rayolsen/Teensy_3_5_VGM_Player_YM2612_SN76489/Docs/Baordv1.2_render_screenshot.png

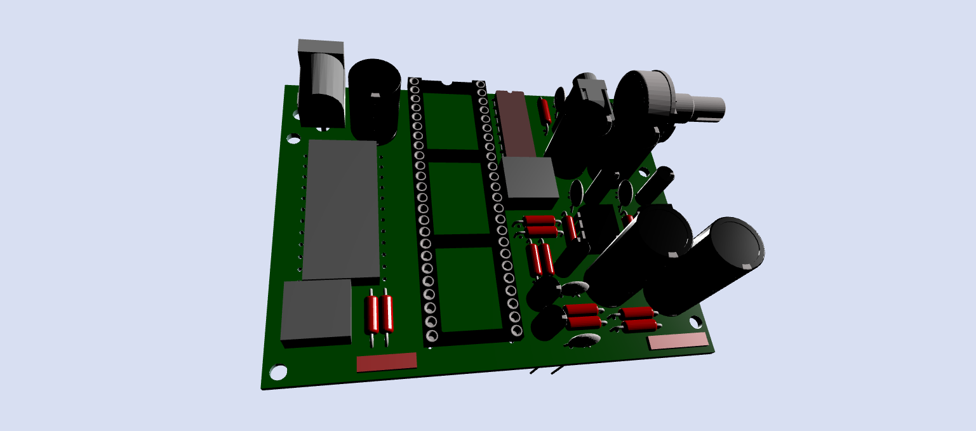
Docs/Baordv1.2_render_screenshot.png
