rayolsen/Teensy_3_5_VGM_Player_YM2612_SN76489/Docs/Case/Case_render_v12.png

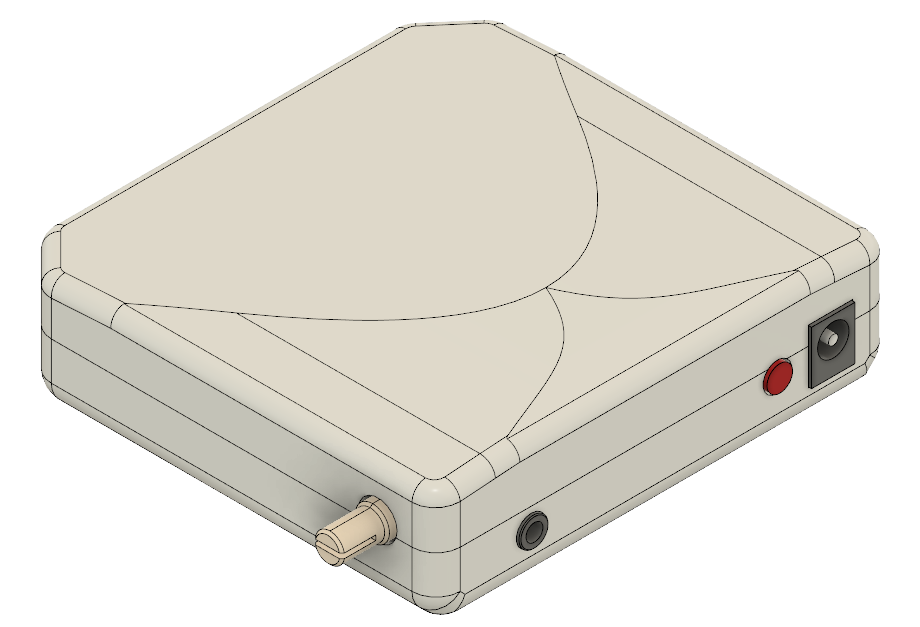
Docs/Case/Case_render_v12.png
