rayolsen/Teensy_3_5_VGM_Player_YM2612_SN76489/Schematics/board_top_gnd_plane.png

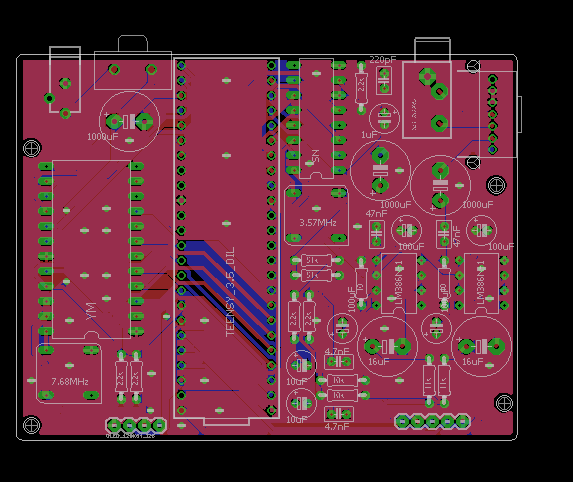
Schematics/board_top_gnd_plane.png
