rayolsen/Teensy_3_5_VGM_Player_YM2612_SN76489/Schematics/Schematic.png

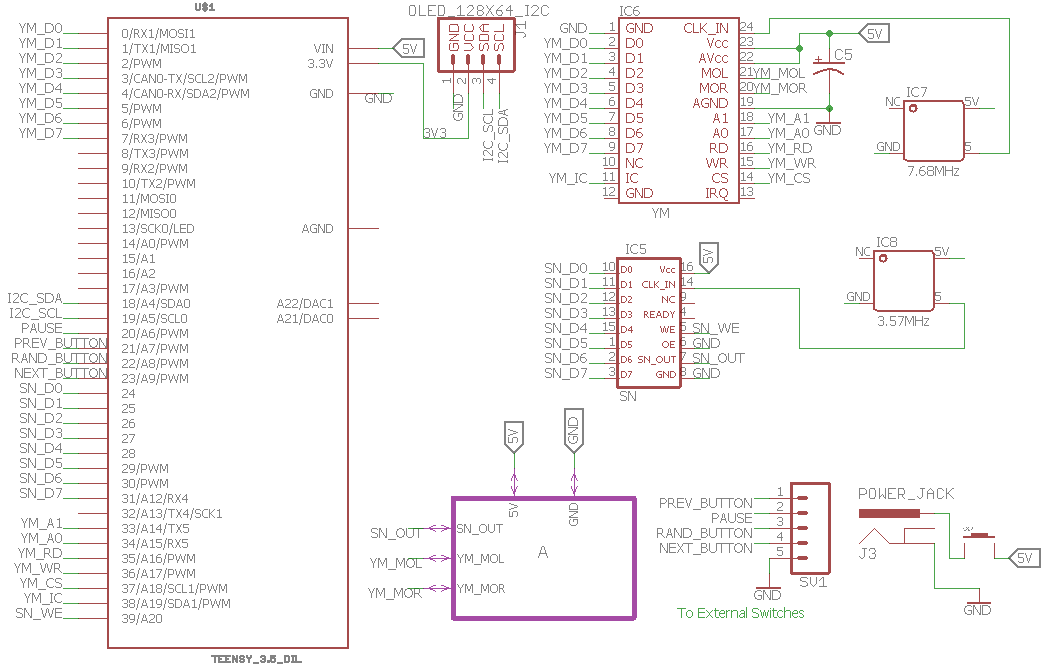
Schematics/Schematic.png
