rayolsen/Teensy_3_5_VGM_Player_YM2612_SN76489/Docs/Case/Bottom_Case.stl

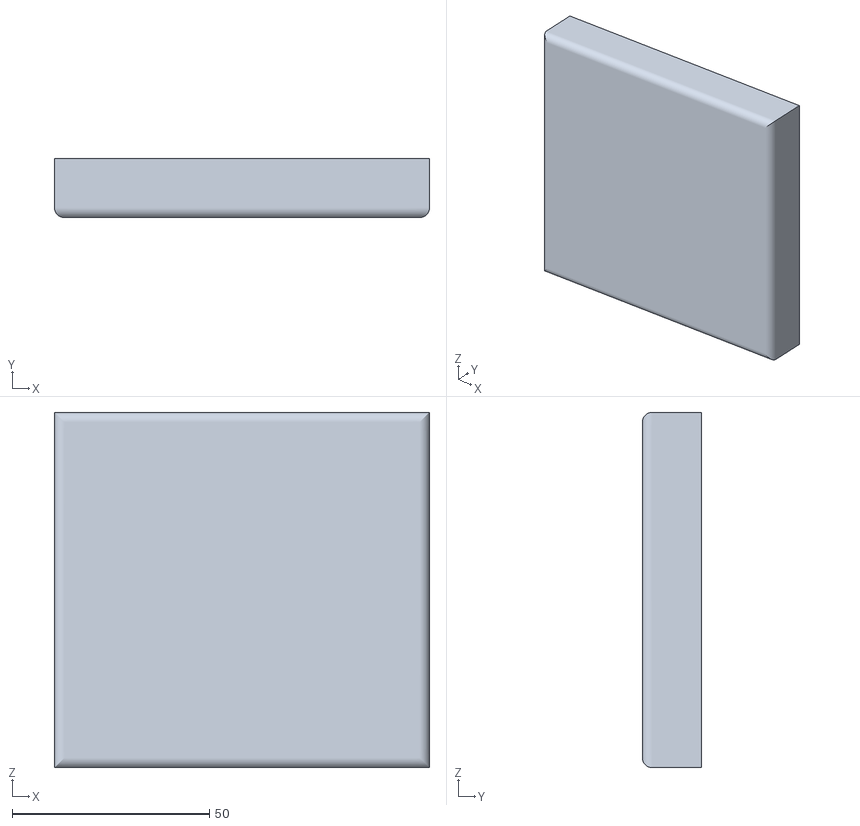
[picture p5: CAD file, 2018-01-02]
Docs/Case/Bottom_Case.stl
95.0 x 15.0 x 90.0
