rayolsen/Teensy_3_5_VGM_Player_YM2612_SN76489/Docs/Case/Boardv1.2_render_low-poly.STL

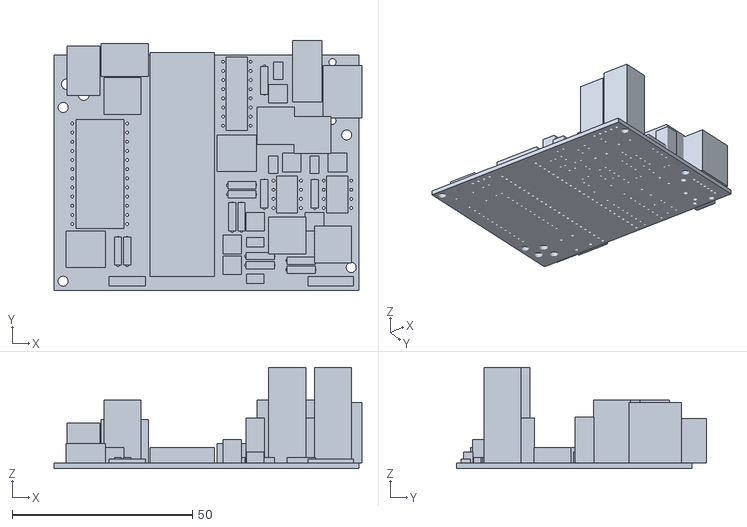
[picture p6: CAD file, 2018-01-02]
Docs/Case/Boardv1.2_render_low-poly.STL
85.5 x 69.4 x 28.1
