rayolsen/Teensy_3_5_VGM_Player_YM2612_SN76489/Schematics/Teensy_3_5_VGM_Player.pdf

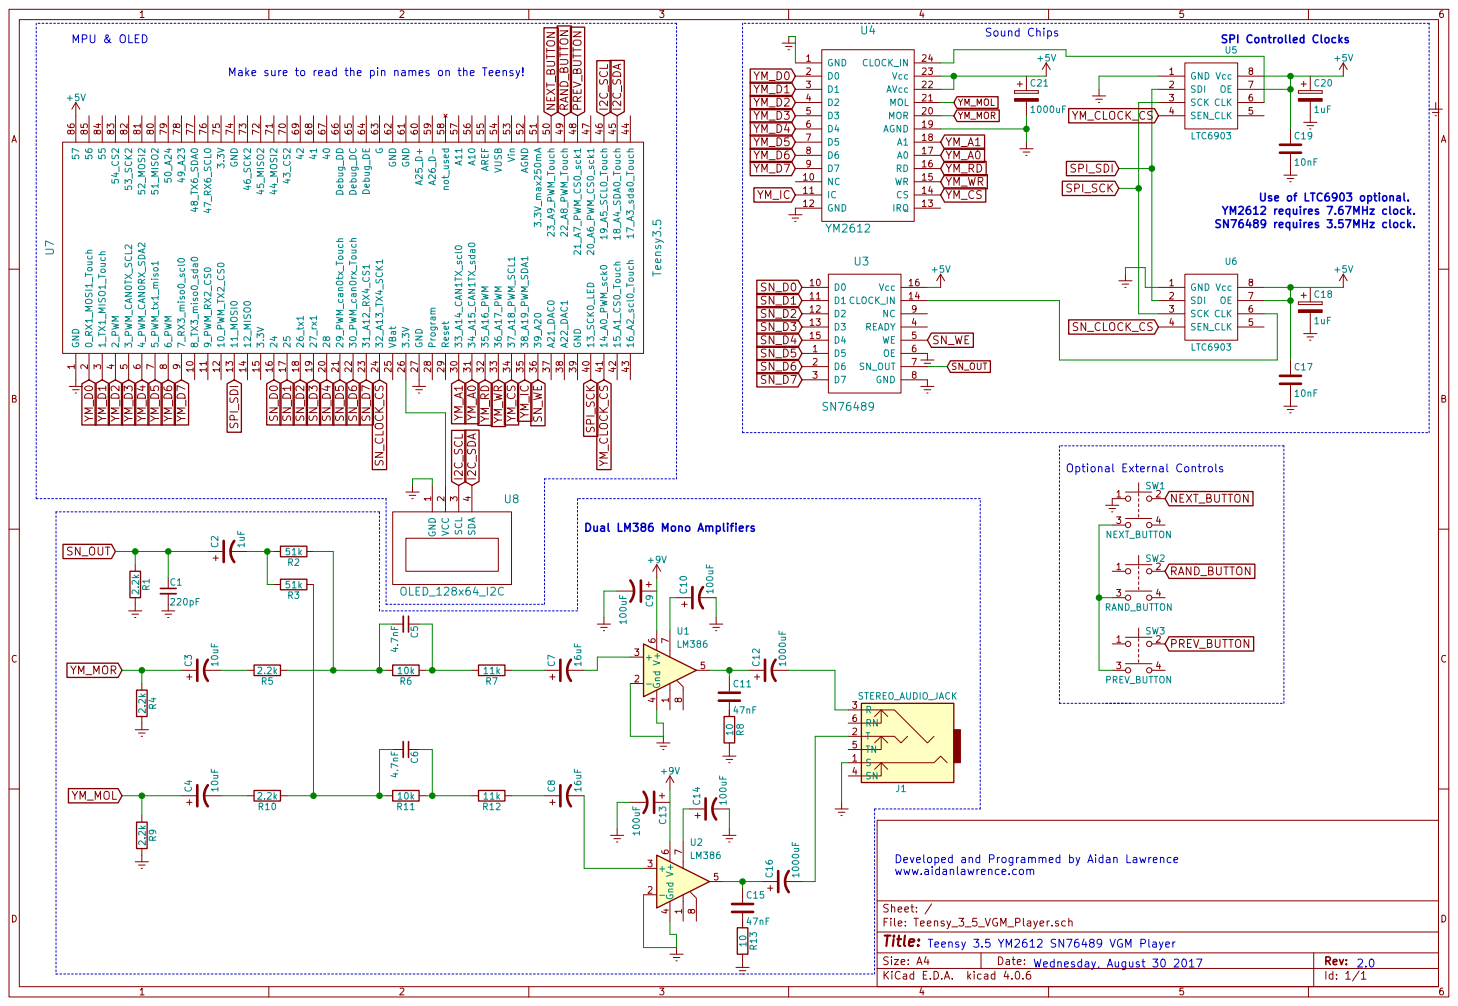
[picture p7: page 1]

Make sure to read the pin names on the Teensy! GND

9 8_TX3_miso0_sda0 10 28 20 33_A14_CAN1TX_scl0 30 13_SCK0_LED 40 23_A9_PWM_Touch 50 A25_D+ 60 43_CS2 70 51_MISO2 80 9_PWM_RX2_CS0 11 29_PWM_can0tx_Touch 21 34_A15_CAN1TX_sda0 31 14_A0_PWM_sck0 41 3.3V_max250mA 51 GND 61 44_MOSI2 71 52_MOSI2 81 10_PWM_TX2_CS0 12 30_PWM_can0rx_Touch 22 35_A16_PWM 32 15_A1_CS0_Touch 42 AGND 52 GND 62 45_MISO2 72 53_SCK2 82 11_MOSI0 13 31_A12_RX4_CS1 23 36_A17_PWM 33 16_A2_scl0_Touch 43 Vin 53 G 63 46_SCK2 73 54_CS2 83 12_MISO0 14 32_A13_TX4_SCK1 24 37_A18_PWM_SCL1 34 17_A3_sda0_Touch 44 VUSB 54 Debug_DE 64 GND 74 55 84 3.3V 15 VBat 25 38_A19_PWM_SDA1 35 18_A4_SDA0_Touch 45 AREF 55 Debug_DC 65 3.3V 75 56 85 24 16 3.3V 26 39_A20 36 19_A5_SCL0_Touch 46 A10 56 Debug_DD 66 47_RX6_SCL0 76 57 86 25 17 GND 27 A21_DAC0 37 20_A6_PWM_CS0_sck1 47 A11 57 40 67 48_TX6_SDA0 77 26_tx1 18 Program 28 A22_DAC1 38 21_A7_PWM_CS0_sck1 48 not_used 58 41 68 49_A23 78 27_rx1 19 Reset 29 GND 39 22_A8_PWM_Touch 49 A26_D- 59 42 69 50_A24 79 U7 Teensy3.5 YM_D0 YM_D1 YM_D2 YM_D3 YM_D4 YM_D5 YM_D6 YM_D7

Developed and Programmed by Aidan Lawrence www.aidanlawrence.com

File: Teensy_3_5_VGM_Player.sch Sheet: / Teensy 3.5 YM2612 SN76489 VGM Player
Id: 1/1 Title:
