rayolsen/Teensy_3_5_VGM_Player_YM2612_SN76489/Schematics/Teensy_v1.3.brd

## EAGLE design Schematics/Teensy_v1.3.brd (2018-02-13)

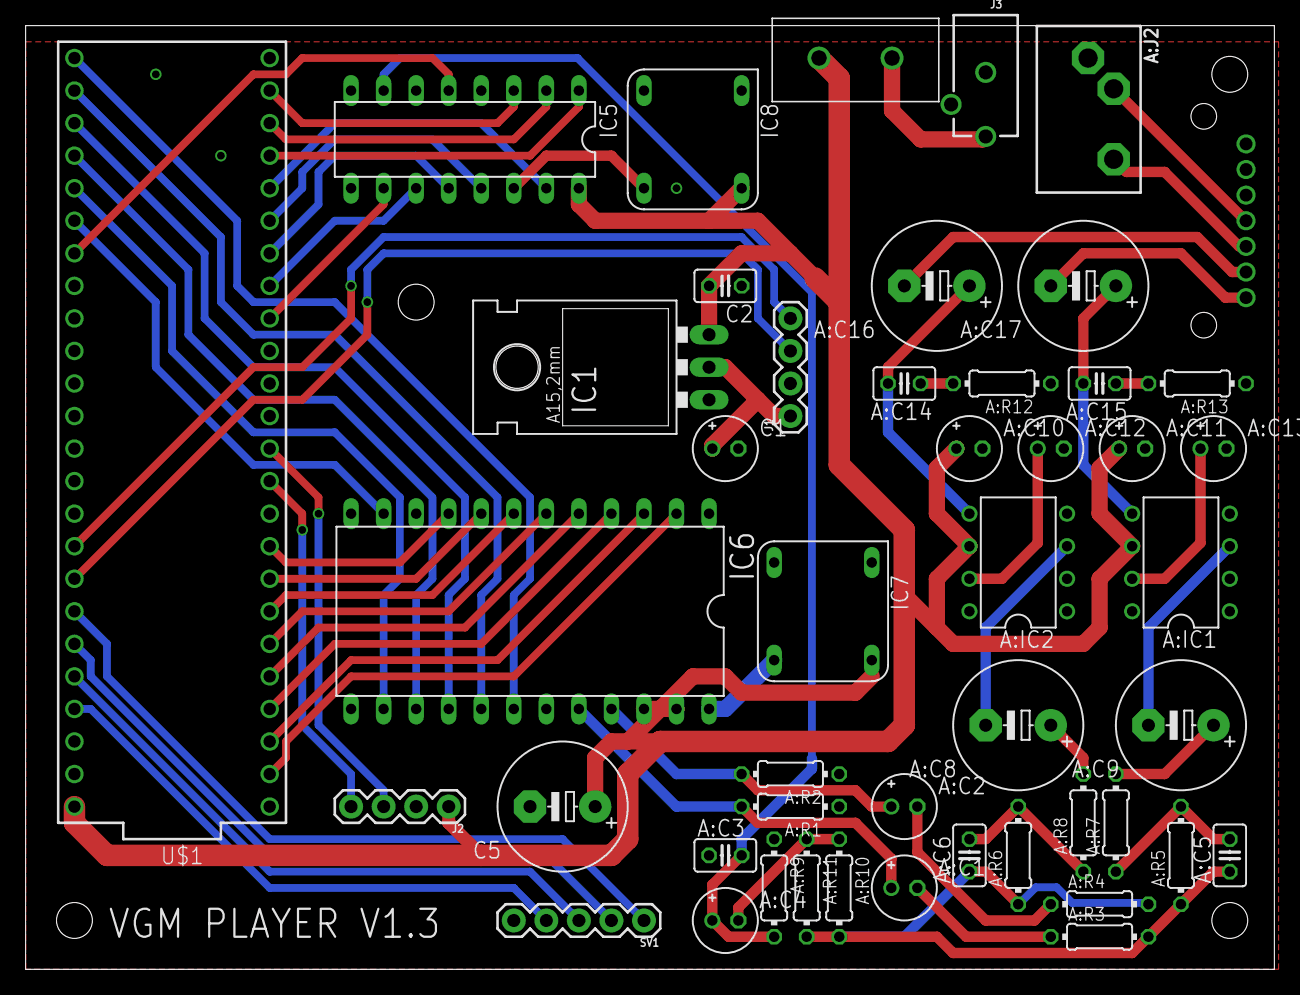
[picture p8: board Teensy_v1.3.brd from above]

Board: 2 copper layers, 97.5 x 73.7 mm, 47 parts (0 on the bottom side), 61 nets.

Parts:
A:C1, A:C2: 10uF; E2-5
A:C3: 220pF; C025-025X050
A:C4: 1uF; E2-5
A:C5, A:C6: 4.7nF; C025-025X050
A:C8, A:C9: 16uF; E5-10,5
A:C10, A:C11, A:C12, A:C13: 100uF; E2-5
A:C14, A:C15: 47nF; C025-025X050
A:C16, A:C17: 1000uF; E5-10,5
A:IC1, A:IC2: LM386N-1; DIL08
A:J2: SJ1-3533NG
A:R1, A:R2, A:R3, A:R4, A:R9: 2.2k; 0204/7
A:R5, A:R6: 10k; 0204/7
A:R7, A:R8: 11k; 0204/7
A:R10, A:R11: 51k; 0204/7
A:R12, A:R13: 10; 0204/7
A:U$1: P140KV1; P14O
C1: 10uF; E2-5
C2: 100nF; C025-025X050
C5: 1000uF; E5-10,5
IC1: LD117AV33; TO220L1
IC5: SN; DIL16
IC6: YM; DIL24-6
IC7: 7.68MHz; DIL08-CLK
IC8: 3.57MHz; DIL08-CLK
J1: OLED_128X64_I2C; 1X04
J2: HC-06; 1X04
J3: POWER_JACK; POWER_JACK_PTH
SV1: 1X05
U$1: TEENSY_3.5_DIL
U$7: GPTS20; GPTS

Connections:
5V: A:C10.+, A:C11.+, A:IC1.6, A:IC2.6, C2.2, C5.+, IC1.3, IC5.16, IC6.22, IC6.23, IC7.5V, IC8.5V, J2.1, U$1.VIN, U$7.P$1
A:N$1: A:C16.-, A:U$1.1
A:N$2: A:C17.-, A:U$1.1'
A:N$3: A:C15.2, A:C17.+, A:IC1.5
A:N$4: A:C14.2, A:C16.+, A:IC2.5
A:N$5: A:C13.+, A:IC1.7
A:N$6: A:C12.+, A:IC2.7
A:N$7: A:C9.-, A:IC1.3
A:N$8: A:C8.-, A:IC2.3
A:N$9: A:C9.+, A:R7.2
A:N$10: A:C8.+, A:R8.2
A:N$11: A:C15.1, A:R13.2
A:N$12: A:C14.1, A:R12.2
A:N$13: A:C6.1, A:R4.2, A:R6.1, A:R10.2
A:N$14: A:C5.1, A:R3.2, A:R5.1, A:R11.2
A:N$15: A:C4.-, A:R10.1, A:R11.1
A:N$16: A:C1.-, A:R3.1
A:N$17: A:C2.-, A:R4.1
A:N$18: A:C5.2, A:R5.2, A:R7.1
A:N$19: A:C6.2, A:R6.2, A:R8.1
A:N$20: A:J2.2, A:U$1.2'
A:N$21: A:J2.3, A:U$1.2
BUTTON1: SV1.1, U$1.20/A6
BUTTON2: SV1.2, U$1.21/A7
BUTTON3: SV1.3, U$1.22/A8
BUTTON4: SV1.4, U$1.23/A9
GND: A:C3.1, A:C10.-, A:C11.-, A:C12.-, A:C13.-, A:IC1.2, A:IC1.4, A:IC2.2, A:IC2.4, A:J2.1, A:R1.1, A:R2.1, A:R9.1, A:R12.1, A:R13.1, A:U$1.3, A:U$1.3', C1.-, C2.1, C5.-, IC1.1, IC5.6, IC5.8, IC6.1, IC6.19, IC7.GND, IC8.GND, J1.2, J2.2, J3.GND, J3.GNDBREAK, SV1.5, U$1.GND, U$1.GND1
I2C_SCL: J1.3, U$1.19/A5
I2C_SDA: J1.4, U$1.18/A4
unnamed: IC6.24, IC7.5
unnamed: J3.PWR, U$7.P$2
unnamed: IC5.14, IC8.5
RX: J2.3, U$1.10
SN_D0: IC5.10, U$1.24
SN_D1: IC5.11, U$1.25
SN_D2: IC5.12, U$1.26
SN_D3: IC5.13, U$1.27
SN_D4: IC5.15, U$1.28
SN_D5: IC5.1, U$1.29
SN_D6: IC5.2, U$1.30
SN_D7: IC5.3, U$1.31/A12
SN_OUT: A:C3.2, A:C4.+, A:R9.2, IC5.7
SN_WE: IC5.5, U$1.39/A20
TX: J2.4, U$1.9
VCC: C1.+, IC1.2, J1.1
YM_A0: IC6.17, U$1.34/A15
YM_A1: IC6.18, U$1.33/A14
YM_CS: IC6.14, U$1.37/A18
YM_D0: IC6.2, U$1.0
YM_D1: IC6.3, U$1.1
YM_D2: IC6.4, U$1.2
YM_D3: IC6.5, U$1.3
YM_D4: IC6.6, U$1.4
YM_D5: IC6.7, U$1.5
YM_D6: IC6.8, U$1.6
YM_D7: IC6.9, U$1.7
YM_IC: IC6.11, U$1.38/A19
YM_MOL: A:C2.+, A:R2.2, IC6.21
YM_MOR: A:C1.+, A:R1.2, IC6.20
YM_RD: IC6.16, U$1.35/A16
YM_WR: IC6.15, U$1.36/A17
