rayolsen/Teensy_3_5_VGM_Player_YM2612_SN76489/Schematics/buttons.brd

## EAGLE design Schematics/buttons.brd (2018-01-02)

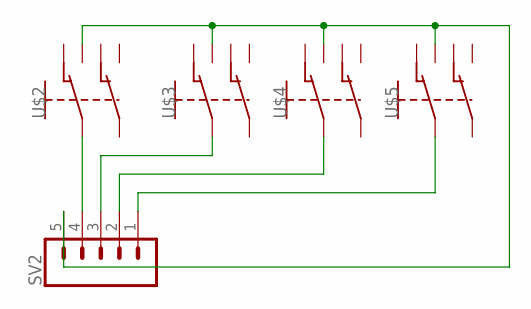
[picture p9: schematic buttons.sch]

Parts:
SV2: CONN_05; 1X05
U$2, U$3, U$4, U$5: PVA2-OA; PVA

Connections:
unnamed: SV2.4, U$2.0
unnamed: SV2.3, U$3.0
unnamed: SV2.2, U$4.0
unnamed: SV2.1, U$5.0
unnamed: SV2.5, U$2.2, U$3.2, U$4.2, U$5.2

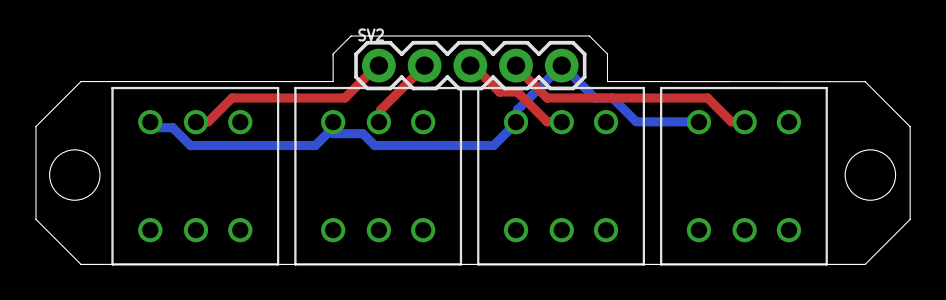
[picture p10: board buttons.brd from above]

Board: 2 copper layers, 48.6 x 12.7 mm, 5 parts (0 on the bottom side), 5 nets.
