rayolsen/Teensy_3_5_VGM_Player_YM2612_SN76489/(commit log)

2018-01-02 combined files and added to rep
    [Teensy_3_5_VGM_Player.kicad_pcb, Teensy_3_5_VGM_Player.sch, Teensy_v1.2.brd, Teensy_v1.2.sch, VGM-Panelized.brd, buttons.brd, buttons.sch]
2018-01-02 More Documents and file organizing
    [Boardv1.2_render_low-poly.STL, Bottom_Case.stl, Teensy_v1.2.brd, Teensy_v1.2.sch, Teensy_v1.brd, Teensy_v1.sch, VGM-Panelized.brd, buttons.brd]
2018-01-05 new version to address issues
    [Teensy_v1.2.brd, Teensy_v1.2.sch, Teensy_v1.3.brd, Teensy_v1.3.sch, Teensy_v1.brd, Teensy_v1.sch, VGM-Panelized.brd, buttons.brd]
2018-02-13 Total Resdesign
    This should probably be considered a 2.0 rev
    [Teensy_v1.3.brd, Teensy_v1.3.sch]
2018-07-16 Uncommented BT code, not working yet
    [ChipPinMapping.h, main.cpp]
