rayolsen/Teensy_3_5_VGM_Player_YM2612_SN76489/(notices)

Notices in the files:
parts and their libraries:
SparkFun-Connectors: Licensing: Creative Commons ShareAlike 4.0 International - https://creativecommons.org/licenses/by-sa/4.0
con-cuistack: Copyright (C) 2008, Bob Starr
